the-real-Nathanael-G/FPGA_Heartrate_Monitor/README.md

# FPGA_Heartrate_Monitor
Work done for a university module to make a functional Heartrate Monitor

Custom PCB was connected to FPGA prototyping board to detect & process PCB signals.
FPGA was connected to STM32 microcontroller to calculate heartrate.
Information displayed on an LCD controlled by FPGA.
