the-real-Nathanael-G/FPGA_Heartrate_Monitor/Hardware/NUCLEO_to_FPGA_Signal_List.xlsx

Sheet: FPGA to NUCLEO
DE0-nano |  |  | NUCLEO
JP1-sig | FPGA_Pin | JP1-pin | CN7 |  | N.B. !!!!
GPIO-02 | PIN_A2 | 5 | 1 | PC_6 | "cs" for Chip Select SPI block to FPGA LEDS/SWITCHES
GPIO-04 | PIN_B3 | 7 | 3 | PB_15 | SPARE1
GPIO-06 | PIN_A4 | 9 | 5 | PB_13 | SPARE2
5VDC |  | 11 | 7 | PB_12 | NUCLEO PIN Must be configured as a DIGITAL INPUT which is 5VDC tolerant
GPIO-08 | PIN_A5 | 13 | 9 | PA_15 | SPARE3
GPIO-010 | PIN_B6 | 15 | 11 | PC_7 | SPARE4
GPIO-012 | PIN_B7 | 17 | 13 | PB_5 | SPI1_MOSI ALTERNATIVE * not used in example
GPIO_03 | PIN_A3 | 6 | 2 | PB_8 | SPARE5
GPIO_05 | PIN_B4 | 8 | 4 | PB_9 | SPARE6
GPIO_07 | PIN_B5 | 10 | 6 | AVDD | FPGA should be configured as an Input as 3V3 supplied to FPGA on this pin
GND |  | 12 | 8 | GND
GPIO_09 | PIN_D5 | 14 | 10 | PA_5 | SPI1_SCLK
GPIO_011 | PIN_A6 | 16 | 12 | PA_6 | SPI1_MISO
GPIO_013 | PIN_D6 | 18 | 14 | PA_7 | SPI1_MOSI
 |  |  |  |  | * This is to counter the known limitation on MBED Website
 |  |  |  |  | https://os.mbed.com/teams/ST/wiki/Nucleo-144pins-ethernet-spi-conflict

Sheet: FPGA to LCD & MOTOR
DE0-nano |  |  | LCD/MOTOR
JP2-sig | FPGA_Pin | JP2-pin | J2* | LCD* | MOTOR HBRIDGE | N.B. !!!!
GPIO-12 | PIN_T14 | 5 | 5 | D2
GPIO-14 | PIN_R13 | 7 | 7 | D4
GPIO-16 | PIN_R12 | 9 | 9 | D6
5VDC |  | 11 | 11 | VDD | 5VDC
GPIO-18 | PIN_T10 | 13 | 13 | R/W
GPIO-110 | PIN_P11 | 15 | 15 | E
GPIO_120 | PIN_P15 | 25 | 25 |  | Opto-Encoder-B
GPIO_122 | PIN_R14 | 27 | 27 |  | MOTOR_1
3V3 |  | 29 | 29
GPIO_10 | PIN_F13 | 2 | 2 | D0
GPIO_11 | PIN_T15 | 4 | 4 | D1
GPIO_13 | PIN_T13 | 6 | 6 | D3
GPIO_15 | PINT12 | 8 | 8 | D5
GPIO_17 | PIN_T11 | 10 | 10 | D7
GND |  | 12 | 12 | GND | GND
GPIO_19 | PIN_R11 | 14 | 14 | RS
GPIO_121 | PIN_P16 | 26 | 26 |  | Opto-Encoder-B
GPIO_122 | PIN_R14 | 28 | 28 |  | MOTOR_2
GND |  | 30 | 30 | GND | GND
 |  |  |  |  |  | *Refer to Schematic FPGA DE0 LCD and H-Bridge
