the-real-Nathanael-G/FPGA_Heartrate_Monitor/group.docx

# Complete the table below.

- Record the URL for your code (GitHub)
- Tick the boxes that apply

GROUP | ……….
GitHub URL | …………………………………………….
Notebook URL | …………………………………………….
KanBan URL | …………………………………………….
Requirement 1 | Fully ☐ | Partially ☐
Requirement 2 | Fully ☐ | Partially ☐
Requirement 3 | Fully ☐ | Partially ☐
Requirement 4 | Fully ☐ | Partially ☐
Requirement 5 | Fully ☐ | Partially ☐
Requirement 6 | Fully ☐ | Partially ☐

Confirm Group Member Names:

1
2
3
4
