the-real-Nathanael-G/FPGA_Heartrate_Monitor/MCU/ELEC241-P1-2023/main.cpp

#include "uop_msb.h"
#include "elec241.h"
//Define an instance of SPI - this is a SPI master device
SPI spi(PA_7, PA_6, PA_5);      // Ordered as: mosi, miso, sclk could use forth parameter ssel

//We often use a separate signal for the chip select. It is VITAL that for each SPI port, only ONE SPI slave device is enabled.
DigitalOut cs(PC_6);            // Chip Select for Basic Outputs to illuminate Onboard FPGA DEO nano LEDs CN7 pin 1

// **************************************************************************
// ******************** NB the following line for F429ZI ******************** 
// *    The following line is essential when using this ribbon connector    *
// **************************************************************************
DigitalIn DO_NOT_USE(PB_12);    // MAKE PB_12 (D19) an INPUT do NOT make an OUTPUT under any circumstances !!!!! ************* !!!!!!!!!!!
                                // This Pin is connected to the 5VDC from the FPGA card and an INPUT that is 5V Tolerant
// **********************************************************************************************************


// **************************************** Function prototypes *********************************************
uint16_t spi_readwrite(uint16_t data);  
// **********************************************************************************************************


// **********************************************************************************************************
// Main function	
// **********************************************************************************************************

char message[4] = {'B','P','M',':'};
char BPM[2] = {'8','4',};

int main() {
    //SET UP THE SPI INTERFACE
    cs = 1;                     // Chip must be deselected, Chip Select is active LOW
    spi.format(16,0);           // Setup the DATA frame SPI for 16 bit wide word, Clock Polarity 0 and Clock Phase 0 (0)
    spi.frequency(1000000);     // 1MHz clock rate
    wait_us(10000);

    // This will hold the 16-bit data returned from the SPI interface (sent by the FPGA)
    // Currently the inputs to the SPI recieve are left floating (see quartus files)
    uint16_t rx;

    while(true)                 
    {
        for(int i = 0; i<=3; i++){
            rx = spi_readwrite(message[i]);     // Send binary 0000 0000 1010 1010
            printf("Recieved: %u\n",rx);    // Display the value returned by the FPGA
            wait_us(1000000);    
        }

        rx = spi_readwrite(512+144);
        printf("Recieved: %u\n",rx);    // Display the value returned by the FPGA
        wait_us(1000000);

        
        rx = spi_readwrite(BPM[0]);
        printf("Recieved: %u\n",rx);    // Display the value returned by the FPGA
        wait_us(1000000);
        rx = spi_readwrite(BPM[1]);
        printf("Recieved: %u\n",rx);    // Display the value returned by the FPGA
        wait_us(1000000);


        rx = spi_readwrite(512+144);
        printf("Recieved: %u\n",rx);    // Display the value returned by the FPGA
        wait_us(1000000);



        // rx = spi_readwrite(512+64);     // Send binary 0000 0000 1010 1010
        // printf("Recieved: %u\n",rx);    // Display the value returned by the FPGA
        // wait_us(1000000);               // 
        // rx = spi_readwrite(512+84);     // Send binary 0000 0000 0101 0101
        // printf("Recieved: %u\n",rx);    // Display the value returned by the FPGA
        // wait_us(1000000);               //
        // rx = spi_readwrite(512+144);
        // printf("Recieved: %u\n",rx);    // Display the value returned by the FPGA
        // wait_us(1000000);
    }
}

// **********************************************************************************************************
// uint16_t spi_readwrite(uint16_t data)
//
// Function for writing to the SPI with the correct timing
// data - this parameter is the data to be sent from the MCU to the FPGA over the SPI interface (via MOSI)
// return data - the data returned from the FPGA to the MCU over the SPI interface (via MISO)
// **********************************************************************************************************

uint16_t spi_readwrite(uint16_t data) {	
	cs = 0;             									//Select the device by seting chip select LOW
	uint16_t rx = (uint16_t)spi.write(data);				//Send the data - ignore the return data
	wait_us(1);													//wait for last clock cycle to clear
	cs = 1;             									//De-Select the device by seting chip select HIGH
	wait_us(1);
	return rx;
}
